shattered97/Lie-Detector/The Truth Meter _ MAKE.pdf

## MAKE: PROJECTS (http://blog.makezine.com/projects/)

# The Truth Meter (http://makezine.com/projects/the-truth-meter-2/)

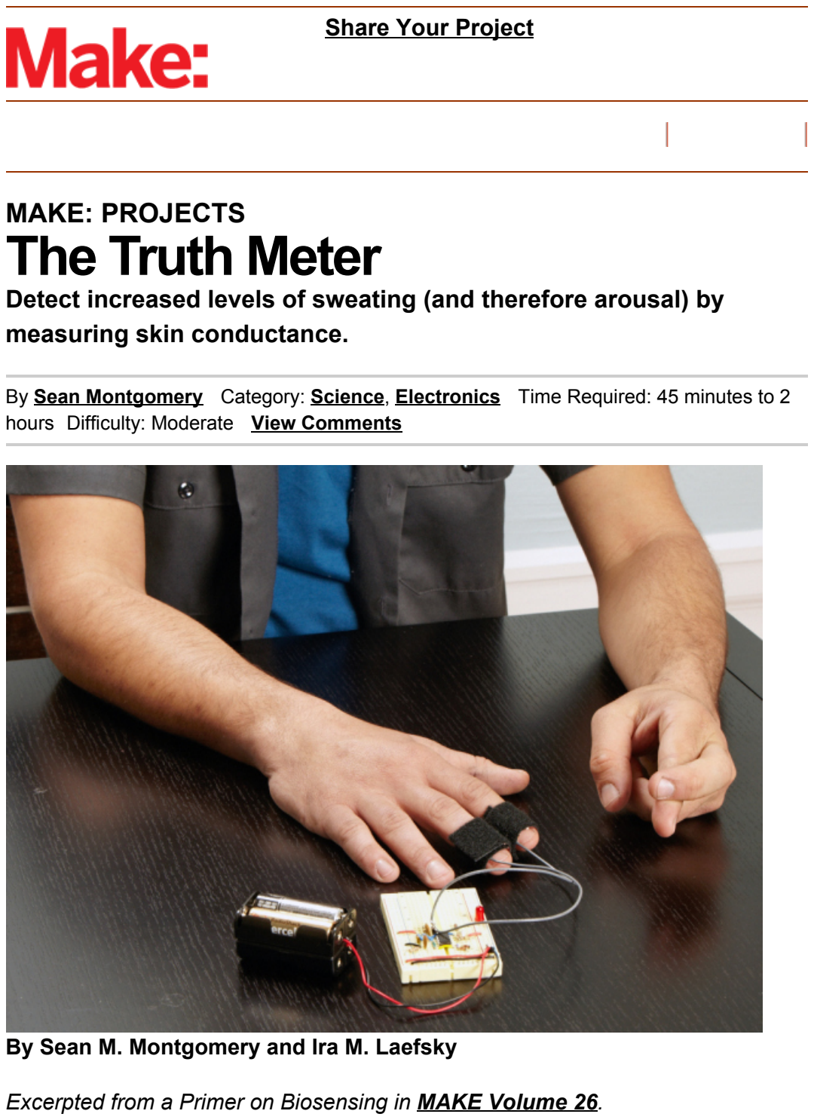
[picture p1: page 1]

Share Your Project (http://makezine.com/contribute/)

### Detect increased levels of sweating (and therefore arousal) by

measuring skin conductance.

By Sean Montgomery (http://makezine.com/author/sean-montgomery/) Category: Science, (http://makezine.com/category/science/) Electronics (http://makezine.com/category/electronics/) Time Required: 45 minutes to 2 hours Difficulty: Moderate View Comments

By Sean M. Montgomery and Ira M. Laefsky

Excerpted from a Primer on Biosensing in MAKE Volume 26. (http://www.makezine.com/26)

When you experience an arousing stimulus, like an evocative question, a startling noise, or even a disturbing thought, your body generates a variety of psychophysical responses.

One of these is micropulses of sweat released after a 1- to 2-second delay from apocrine sweat glands that are tied to the arousal systems in your body via adrenaline and other hormones. The reason your palms might get sweaty during public speaking or a job interview, for example, is because your mind is on high alert and every small stimulus generates one of these pulses.

Each pulse of sweat increases the electrical conductance of your skin, and when this conductance is measured and tied to arousing stimuli, it’s referred to as galvanic skin response (GSR). The Truth Meter measures GSR for display on an LED or for input to a microcontroller. It’s called a Truth Meter because GSR is an important component of lie detector (polygraph) tests used to assess how nervous subjects are while answering questions during interrogation.

So how do we measure GSR? The first step is to understand the signal. With each pulse of sweat, skin resistance decreases suddenly and creeps slowly back up as the sweat evaporates. The Truth Meter circuit transforms this pattern of drops and slow recoveries into sharp spikes deviating from a steady baseline, to light an output LED or trigger some other action.

The resistance sensor itself is simply 2 metal cuffs attached around your fingers with a piece of velcro. Hypoallergenic metals used in jewelry and those less reactive with skin, such as stainless steel, are the best, but any solderable metal will work. We recommend copper or brass foil. Fingers are a good place for measuring GSR because apocrine sweat glands occur in very high concentrations on fingers and palms.

Follow

Follow “MAKE”
Get every new post delivered to your Inbox.

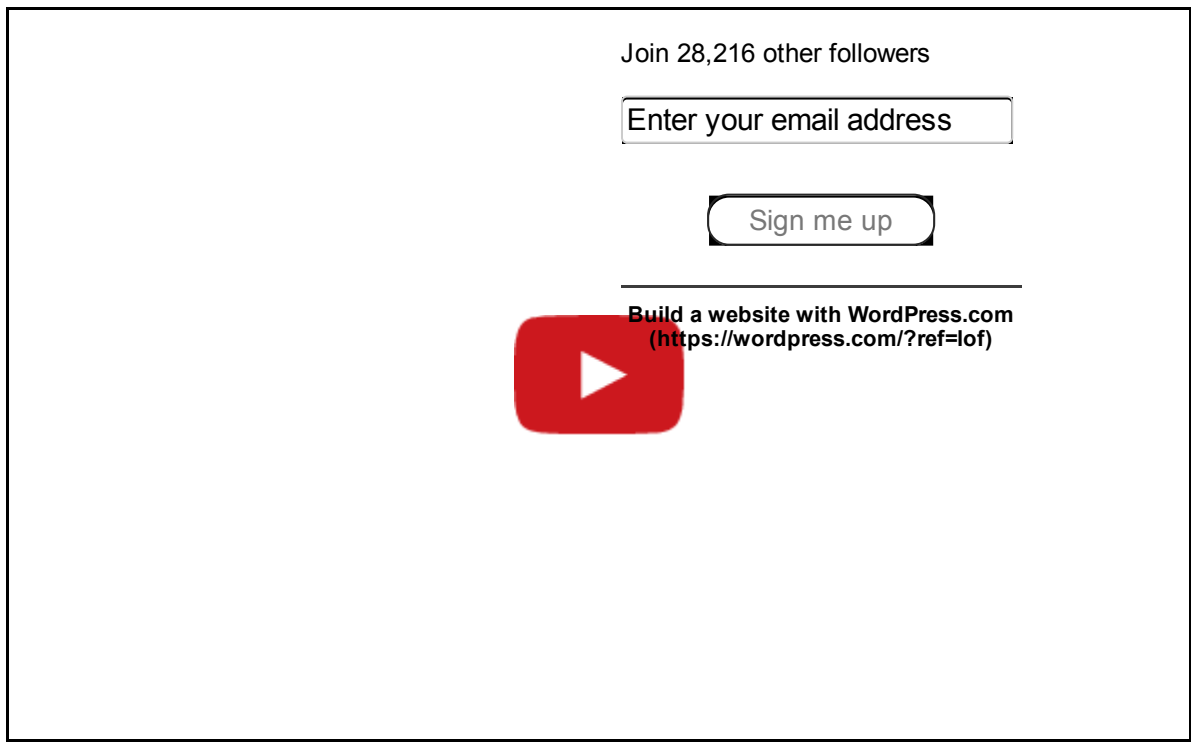
[picture p2: figure]
Join 28,216 other followers; Enter your email address; Sign me up; Build a website with WordPress.com (https://wordpress.com/?ref=lof)

PARTS
Resistors, 1∕4W: 3.3MΩ (2)
Resistors, 1∕4W: 220Ω , 10kΩ, 100kΩ, 1MΩ (1) Dual opamp IC, MCP6002 (1)
Capacitors: 10nF (1)
Capacitors: 0.1μF (2)
LED, Red (1) (http://www.radioshack.com/product/index.jsp?productId=2062554)
Diodes, 1N4001 (3)
Battery holder, 4xAA (1) (http://www.radioshack.com/product/index.jsp?productId=2062253)
Batteries, AA (4) (http://www.radioshack.com/product/index.jsp?productId=10809940&filterName=Type&filterValue=AA)
Copper or brass foil, 36 gauge (0.005') or thinner, 1' wide, 6' long (1) Velcro tape, 3∕4'

, 7' long (1)
Insulated wire, 18 gauge, 10' lengths (2)
Headers, 2-pin (2)
Jumper wire kit (1) (http://www.radioshack.com/product/index.jsp?productId=11980148)
Solderless breadboard (1) (http://www.radioshack.com/product/index.jsp?productId=2734155&prodFindSrc=cart)
Truth Meter Kit (1) (http://www.makershed.com/ProductDetails.asp?ProductCode=MSGR01)

TOOLS
Scissors (http://makeprojects.com/Item/Scissors)
Soldering Iorn (http://makeprojects.com/Item/Soldering_Iorn)
Wire cutter/stripper (http://www.radioshack.com/product/index.jsp?productId=3932543)

Print Project

Next

# STEPS

## PROJECT STEPS

1. Make the 2 sensors.
2. Lay a 1"×3" strip of...
3. Build the circuit.
4. Another RC circuit forms a...
5. Test your truth meter.

Step #1: Make the 2 sensors.

Prev

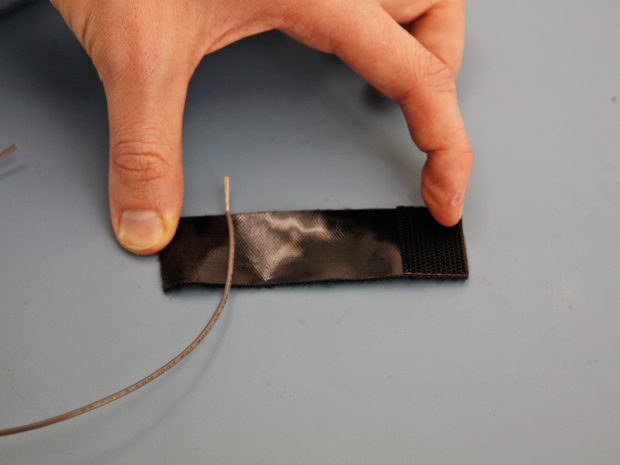
[picture p3: figure]

Next Prev

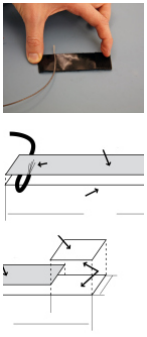
[picture p4: figure]

Cut some 3∕4" velcro tape into a 3½" piece of loop (soft) side and a 3∕4" square of hook (rough) side.
Peel off the tape backing, and align and stick the hook velcro, back to back, at one end of the loop velcro.
Cut a 10" length of 18-gauge wire and strip 1∕2" off one end. Lay the stripped end of the wire perpendicularly across the end of the loop velcro’s sticky side so that its stripped portion hangs off the edge.

# Step #2:

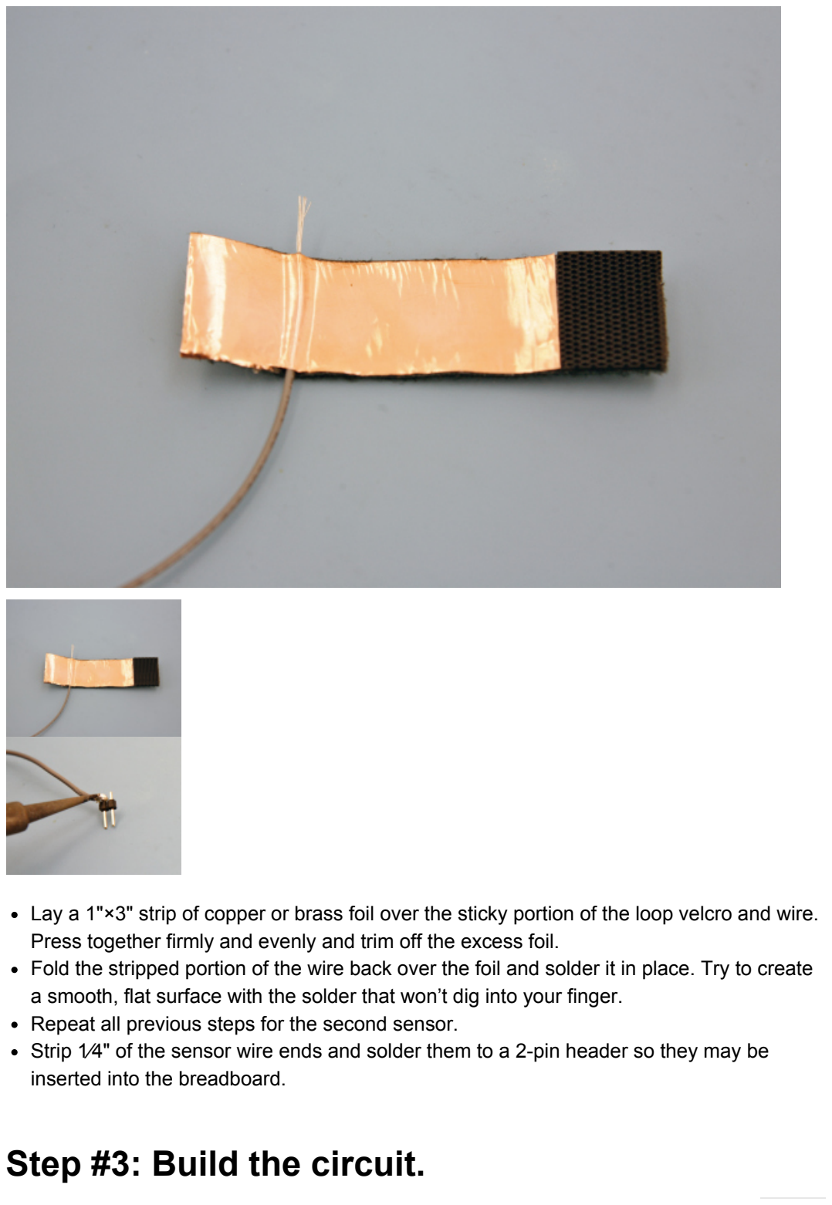
[picture p5: page 6]

Lay a 1"×3" strip of copper or brass foil over the sticky portion of the loop velcro and wire. Press together firmly and evenly and trim off the excess foil.
Fold the stripped portion of the wire back over the foil and solder it in place. Try to create a smooth, flat surface with the solder that won’t dig into your finger.
Repeat all previous steps for the second sensor.
Strip 1∕4" of the sensor wire ends and solder them to a 2-pin header so they may be inserted into the breadboard.

Step #3: Build the circuit.

Next Prev

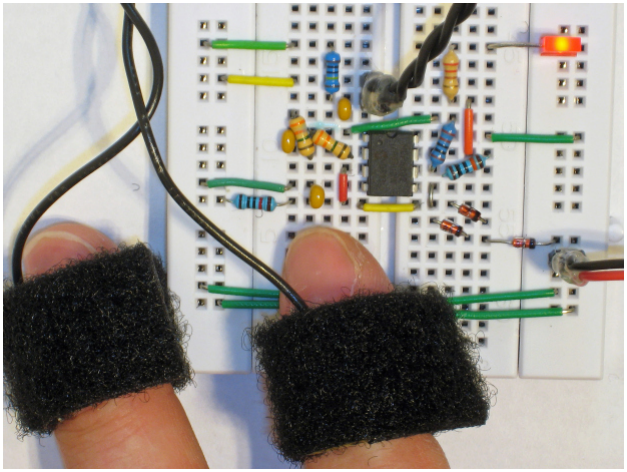
[picture p6: figure]

The Truth Meter circuit is quite simple. The schematic diagram in Step 4 shows all its electronic components and connections, and this photo shows them assembled using jumper wires on a standard 830-hole solderless breadboard from RadioShack (see http://makezine.com/26/primer for a higherresolution photo). This section includes the “conceptual steps” for building it, following the GSR’s signal path from sensor to amplified output.
The battery voltage connects to the power rails along each side of the breadboard. The sensor cuffs connect to V+ and V–, with a highresistance (1MΩ) resistor between V– and one cuff. This resistor acts as a voltage divider, converting the resistance from the sensor into a voltage. Using a highvalue resistor this way can introduce noise, but it has the benefit of making the resistancevoltage curve roughly linear over a wide range of skin resistances.
Skin resistance can vary greatly, depending on individual differences, weather, mental state, etc., so our circuit needs to calibrate to a steady baseline. To enable this, a resistor/capacitor (RC) highpass filter cuts out longer frequencies under ~0.5Hz. This steadies the signal to create a usable baseline while still letting through the shorter GSR signals.

Next Prev

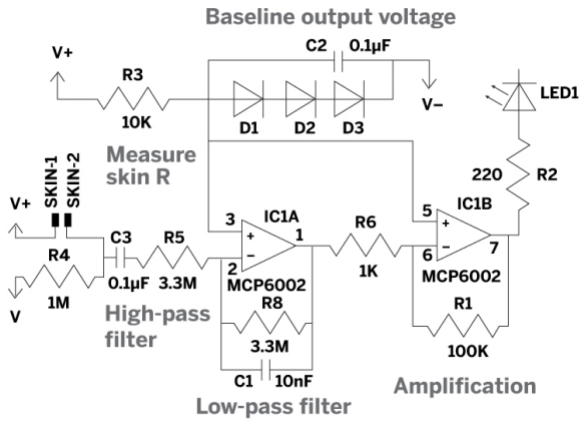
[picture p7: figure]

Prev

# Step #4:

Another RC circuit forms a lowpass filter to remove frequencies above ~5Hz, thus filtering out highfrequency noise such as 60Hz originating from nearby AC power wires. A series of diodes sets the baseline voltage (from V–) at the opamp’s input (+) pin to about +1.6V, just below the threshold required to light the red LED. Depending on the diodes’ current/voltage characteristics, this usually requires 3 diodes. Put them in the circuit and use a multimeter to test the voltage drop between opamp (+) and V–. Add a diode to raise the drop or remove one to decrease it.
For final amplification, so that the output voltage will cross the LED’s threshold with signal spikes, a 100kΩ resistor sets the opamp’s amplification very high. If the circuit is too sensitive to GSR and the LED flashes too often, swap the resistor between the amp’s (–) input and output for a 10kΩ–20kΩ, or use a potentiometer if you want more control.

Step #5: Test your truth meter.

Next

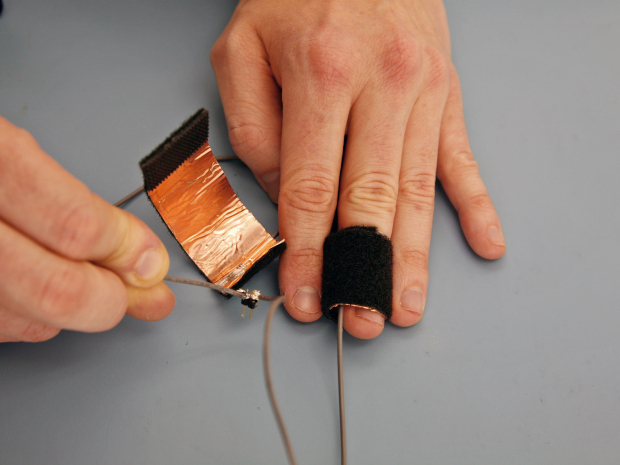
[picture p8: figure]

Insert your battery leads into the side rails of the breadboard (check orientation, red = V+), slip on the sensor cuffs, and behold your very own Truth Meter. See what happens when someone asks you questions or when you laugh or get surprised. Note the response has a 1- to 2-second delay. Everyone responds differently. See if you can turn the LED on with your mind. Try it on your friends, acquaintances, or adversaries. It’s a great way to get to know someone!

# CONCLUSION

This project first appeared in MAKE Volume 26. (http://makezine.com/26/)

SEAN MONTGOMERY (http://makezine.com/author/sean-montgomery)

Ghostery blocked comments powered by Disqus.

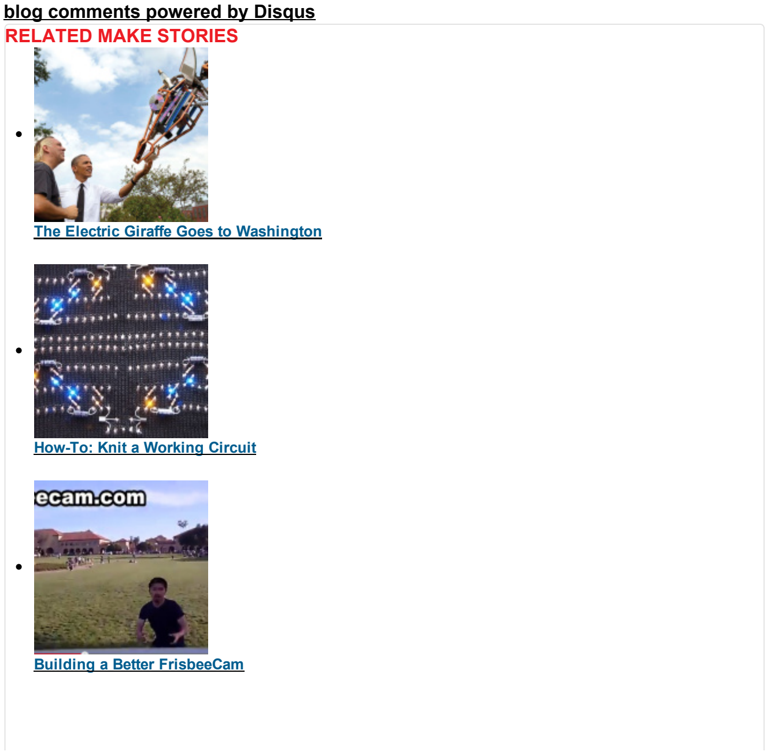
[picture p9: figure]
blog comments powered by Disqus RELATED MAKE STORIES; The Electric Giraffe Goes to Washington; How-To: Knit a Working Circuit; Building a Better FrisbeeCam

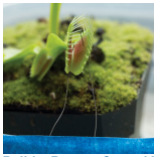
[picture p10: figure]

Build a Remote-Control Venus Flytrap (http://makezine.com/projects/make-39/rcflytrap/)

MAKE VIDEOS

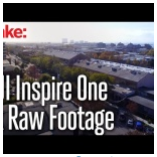
[picture p11: figure]

DJI Inspire One: 4k Raw Aerial Footage (https://www.youtube.com/watch?v=HtKa4rcB4Dk&feature=youtube_gdata)

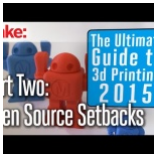
[picture p12: figure]

The Ultimate Guide to 3d printing 2015: Open Source Setbacks (https://www.youtube.com/watch?v=icGxy3e4VM0&feature=youtube_gdata)

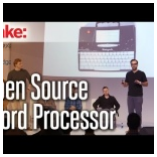
[picture p13: figure]

MAKE @ Engadget Expand 2014: Hemingwrite (https://www.youtube.com/watch?v=_oXBZFK4wWg&feature=youtube_gdata)

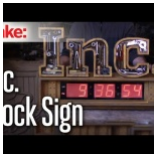
[picture p14: figure]

Inc. Clock Sign (http://www.youtube.com/watch?v=Kmt2U1NN5Rg&feature=youtube_gdata)

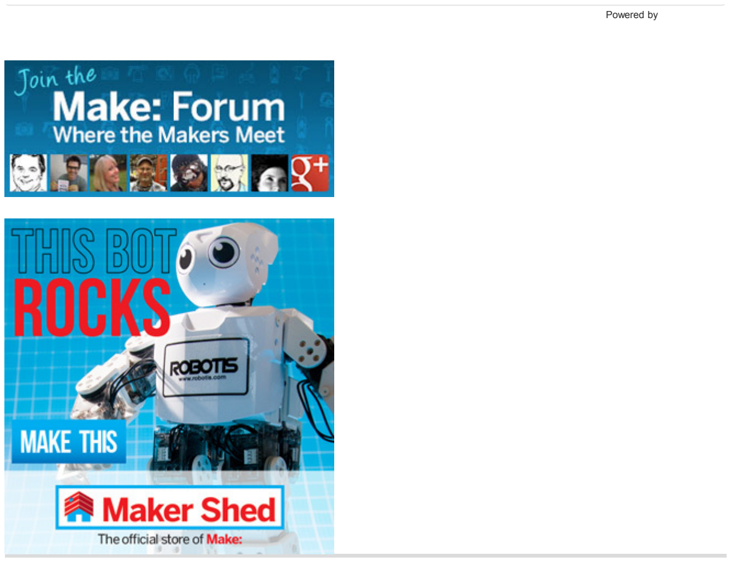
[picture p15: figure]
Powered by
